basheeraltawil/belt-marking-machine-integrated-with-laser-fiber/analysis/figures/lead_feasibility.png

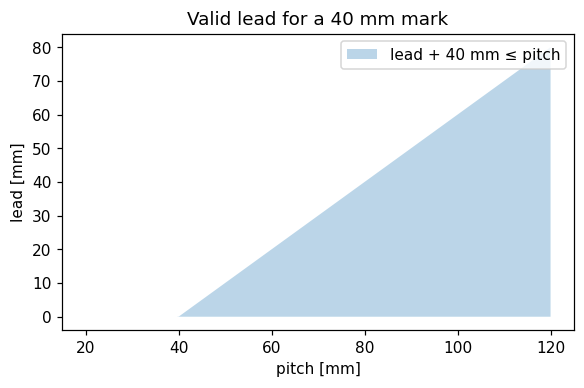
analysis/figures/lead_feasibility.png
