basheeraltawil/belt-marking-machine-integrated-with-laser-fiber/legacy/control_panel_design/Assem1.SLDASM

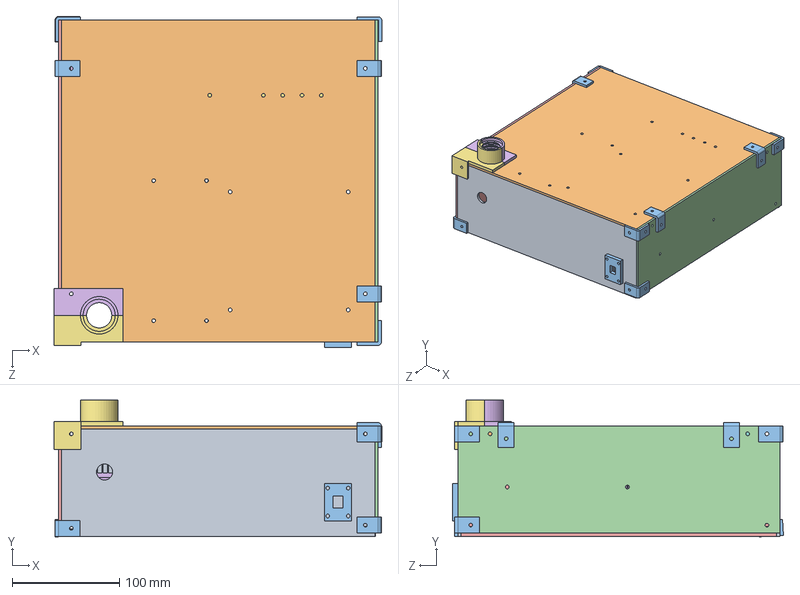
[picture p13: CAD file, 2026-09-28, an earlier design]
legacy/control_panel_design/Assem1.SLDASM
305.4 x 127.5 x 308.4 mm
basen
wall2
holderr x 10
baseupn
baseup
dm542
7 INCH DIN RAIL
driver
left_sidee
KART_HOLDER
usb
relay_support
relaasy
control_cable
control_cable_up
