basheeraltawil/belt-marking-machine-integrated-with-laser-fiber/legacy/control_panel_design/switch.SLDASM

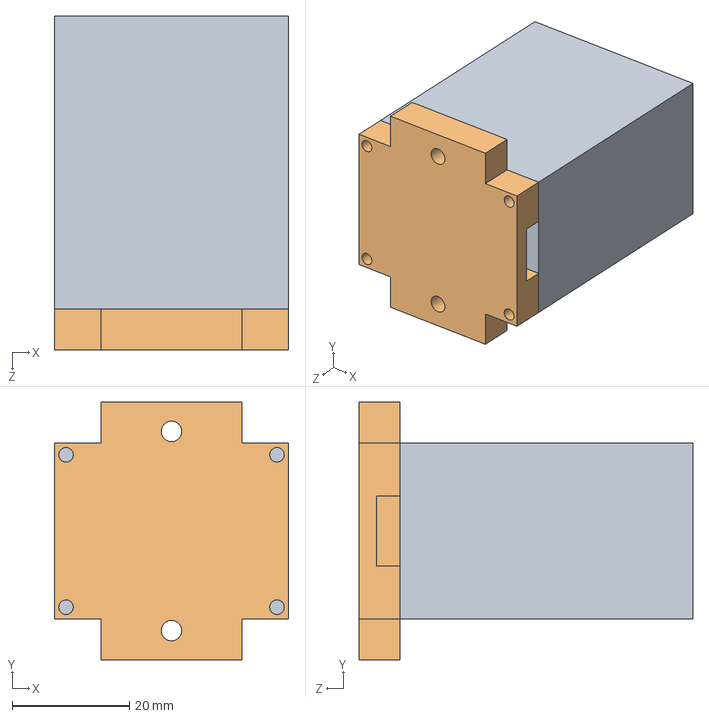
[picture p14: CAD file, 2026-09-28, an earlier design]
legacy/control_panel_design/switch.SLDASM
40.0 x 44.0 x 57.0 mm
switch_body
cover
