basheeraltawil/belt-marking-machine-integrated-with-laser-fiber/legacy/control_panel_design/last_assembly.SLDASM

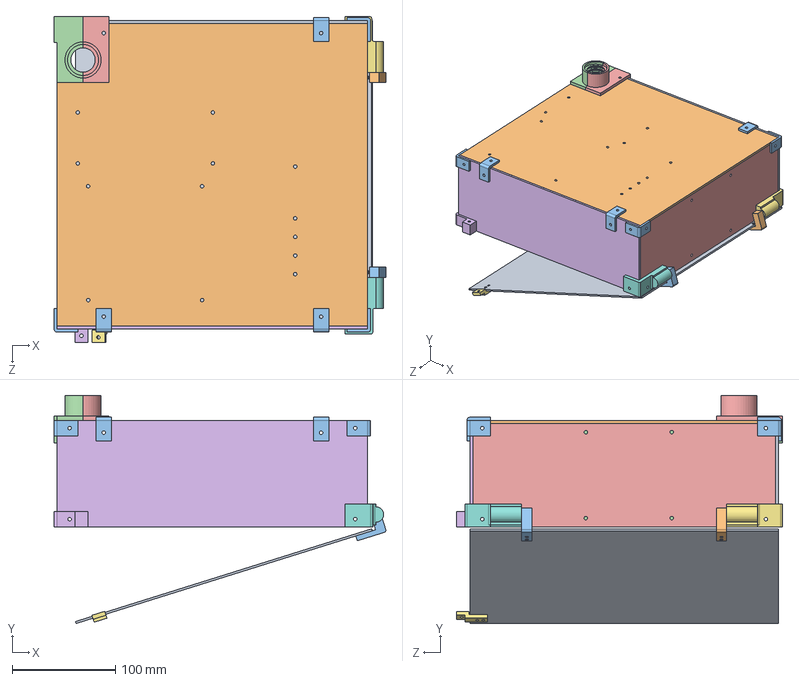
[picture p15: CAD file, 2026-09-28, an earlier design]
legacy/control_panel_design/last_assembly.SLDASM
320.7 x 220.4 x 315.0 mm
baseup
wall2
holderr x 6
basen
left_sidee
upper_d
hinge1
hinge2
kapi
revoluttt1
upper_revolute
control_cable_up
control_cable
totucu
kapi_totucu
