basheeraltawil/belt-marking-machine-integrated-with-laser-fiber/legacy/control_panel_design/sensor_reservior_cover.SLDPRT

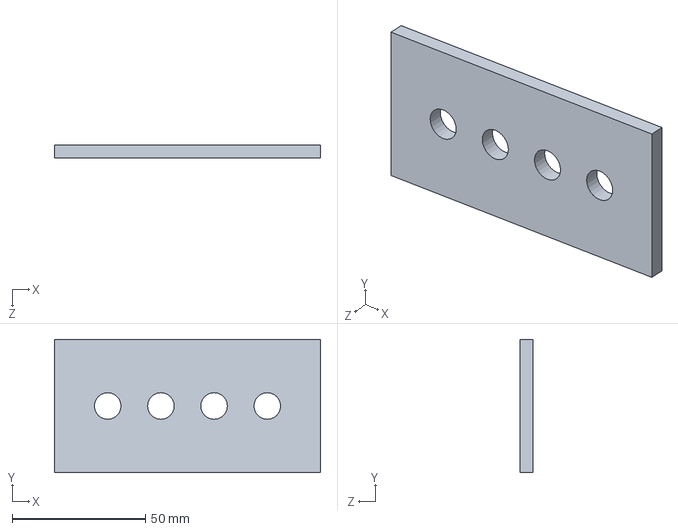
[picture p16: CAD file, 2026-09-28, an earlier design]
legacy/control_panel_design/sensor_reservior_cover.SLDPRT
100.0 x 50.0 x 5.00 mm
