basheeraltawil/belt-marking-machine-integrated-with-laser-fiber/legacy/control_panel_design/step_dosyasi/base.STEP

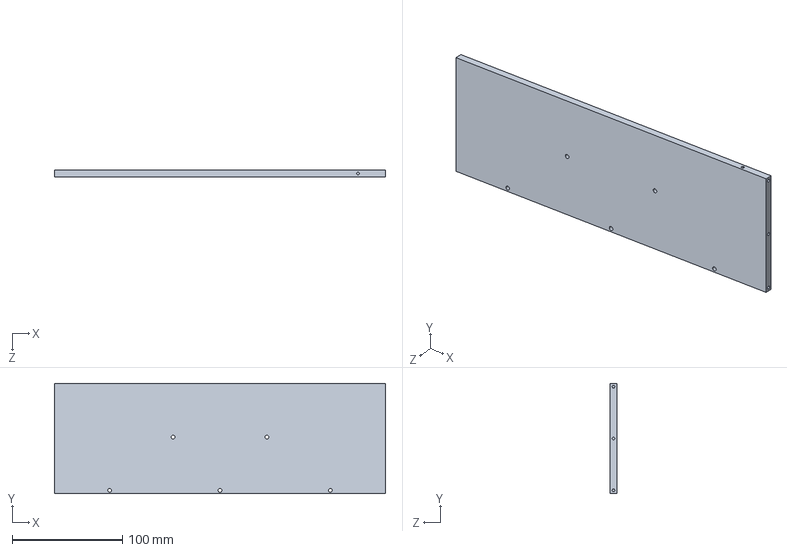
[picture p17: CAD file, 2026-09-28, an earlier design]
legacy/control_panel_design/step_dosyasi/base.STEP
300.0 x 100.0 x 6.00 mm
