basheeraltawil/belt-marking-machine-integrated-with-laser-fiber/legacy/control_panel_design/stepp_file/wall2.STEP

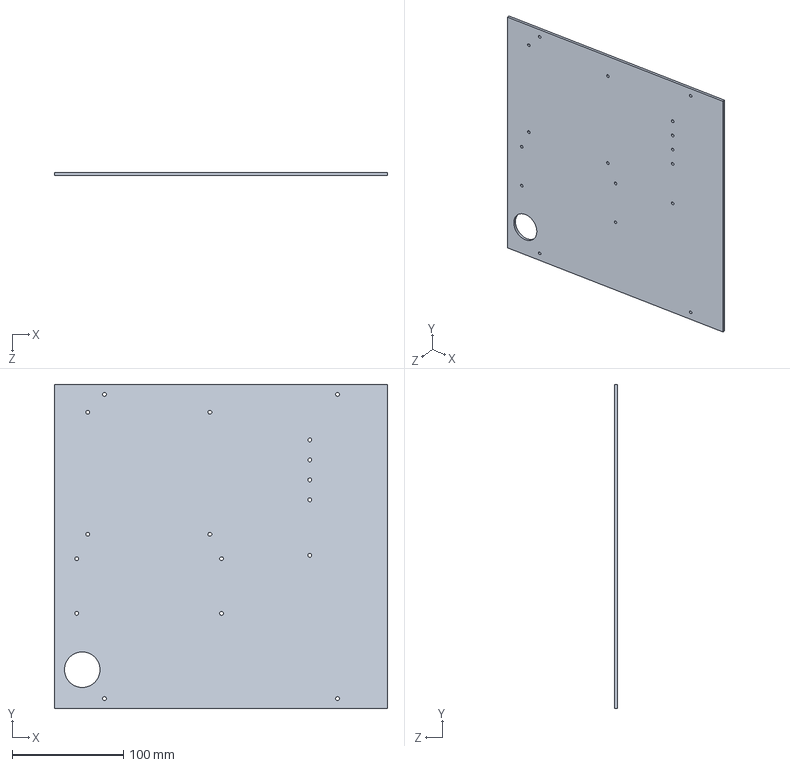
[picture p18: CAD file, 2026-09-28, an earlier design]
legacy/control_panel_design/stepp_file/wall2.STEP
300.0 x 292.0 x 3.00 mm
