basheeraltawil/belt-marking-machine-integrated-with-laser-fiber/legacy/control_panel_design/stepp_file/baseupn.STEP

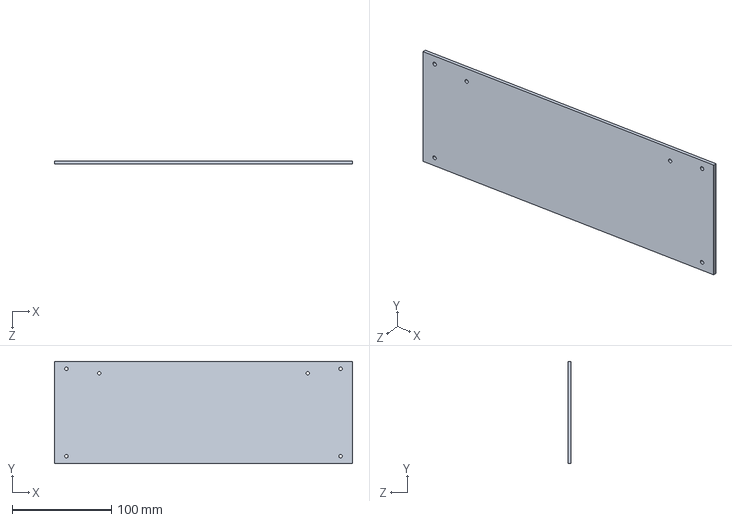
[picture p19: CAD file, 2026-09-28, an earlier design]
legacy/control_panel_design/stepp_file/baseupn.STEP
300.0 x 103.0 x 3.00 mm
