basheeraltawil/belt-marking-machine-integrated-with-laser-fiber/legacy/control_panel_design/switch_body.SLDPRT

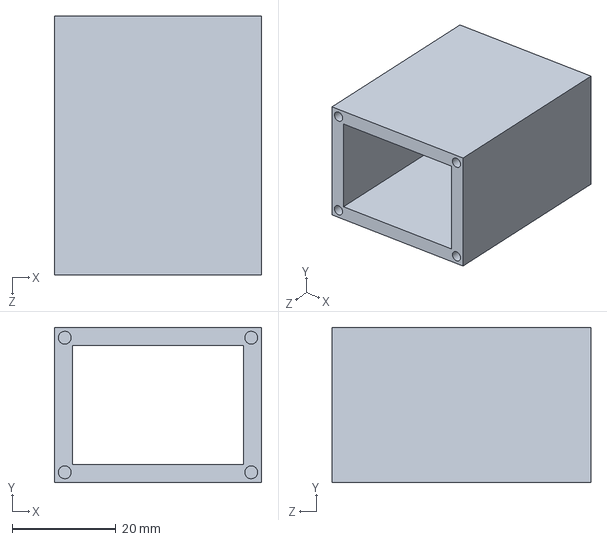
[picture p20: CAD file, 2026-09-28, an earlier design]
legacy/control_panel_design/switch_body.SLDPRT
40.0 x 30.0 x 50.0 mm
