basheeraltawil/belt-marking-machine-integrated-with-laser-fiber/legacy/control_panel_design/B18.3.4M - 3 x 0.5 x 12 SBHCS --C.sldprt

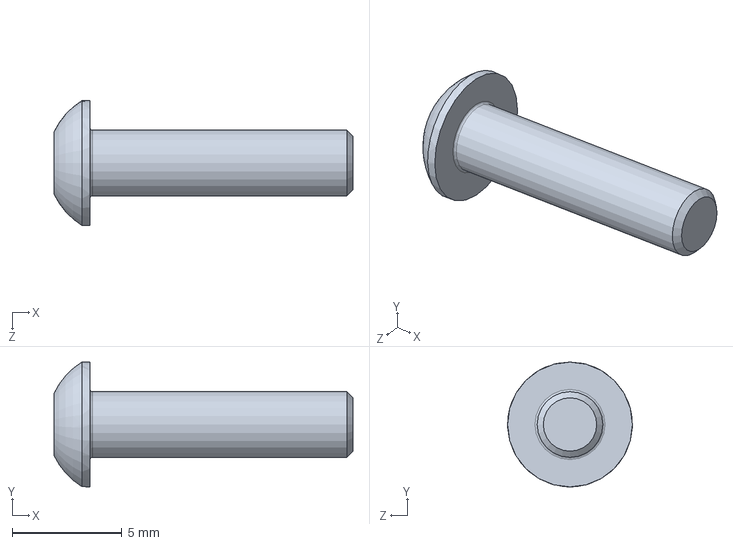
[picture p21: CAD file, 2026-09-28, an earlier design]
legacy/control_panel_design/B18.3.4M - 3 x 0.5 x 12 SBHCS --C.sldprt
13.6 x 5.70 x 5.70 mm
