basheeraltawil/belt-marking-machine-integrated-with-laser-fiber/legacy/control_panel_design/step_dosyasi/holder.STEP

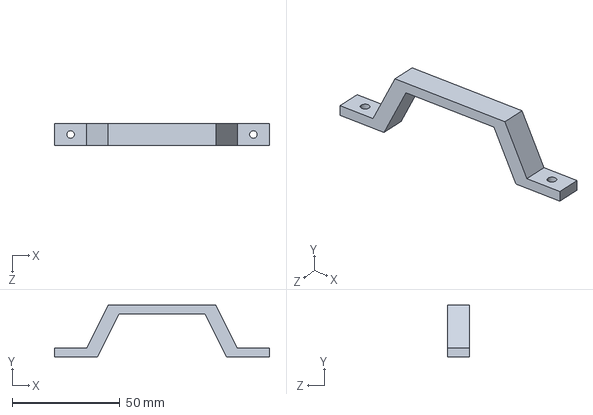
[picture p22: CAD file, 2026-09-28, an earlier design]
legacy/control_panel_design/step_dosyasi/holder.STEP
100.0 x 24.0 x 10.0 mm
