basheeraltawil/belt-marking-machine-integrated-with-laser-fiber/legacy/control_panel_design/stepp_file/holderr.STEP

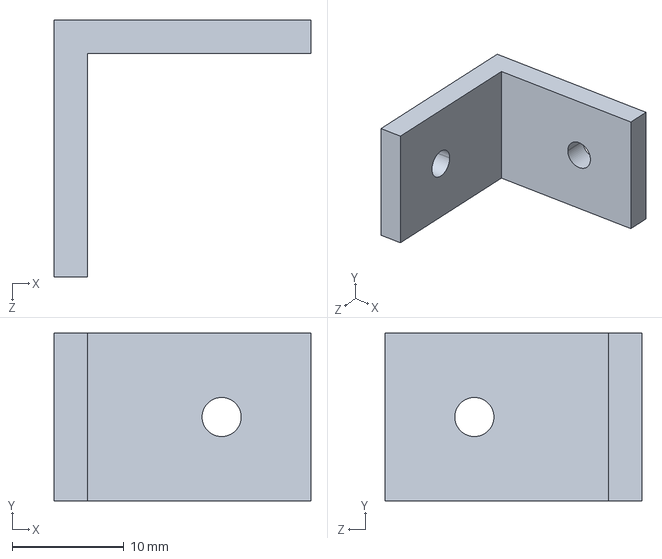
[picture p23: CAD file, 2026-09-28, an earlier design]
legacy/control_panel_design/stepp_file/holderr.STEP
23.0 x 15.0 x 23.0 mm
