basheeraltawil/belt-marking-machine-integrated-with-laser-fiber/legacy/control_panel_design/step_dosyasi/sides.STEP

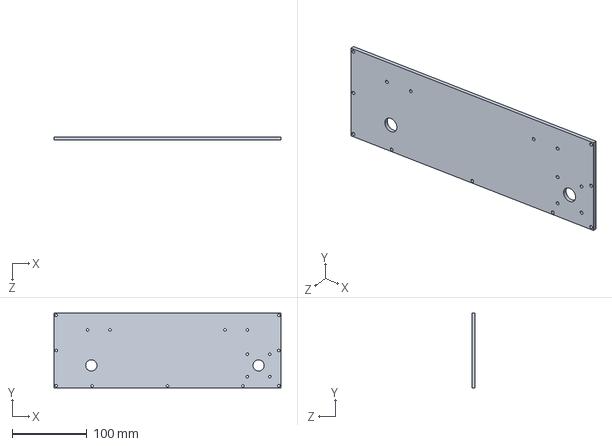
[picture p24: CAD file, 2026-09-28, an earlier design]
legacy/control_panel_design/step_dosyasi/sides.STEP
304.0 x 100.0 x 4.00 mm
