basheeraltawil/belt-marking-machine-integrated-with-laser-fiber/legacy/control_panel_design/stepp_file/left_sidee.STEP

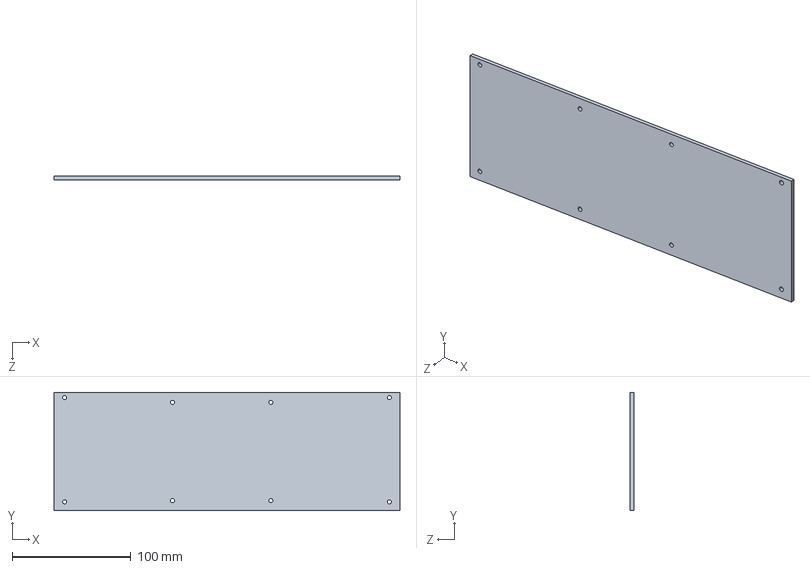
[picture p25: CAD file, 2026-09-28, an earlier design]
legacy/control_panel_design/stepp_file/left_sidee.STEP
292.0 x 100.0 x 3.00 mm
