basheeraltawil/belt-marking-machine-integrated-with-laser-fiber/legacy/control_panel_design/upper_revolute.SLDPRT

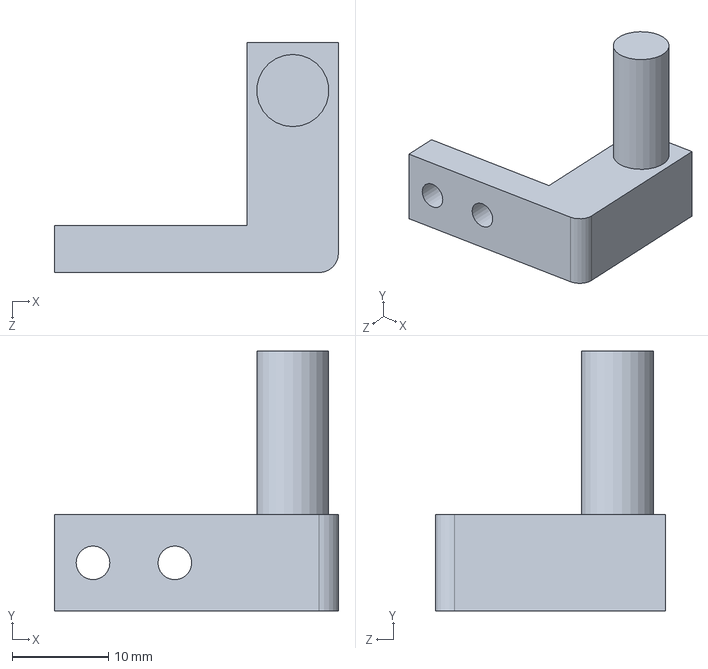
[picture p26: CAD file, 2026-09-28, an earlier design]
legacy/control_panel_design/upper_revolute.SLDPRT
29.5 x 27.0 x 23.9 mm
