basheeraltawil/belt-marking-machine-integrated-with-laser-fiber/legacy/control_panel_design/circulation_pipe_2.SLDPRT

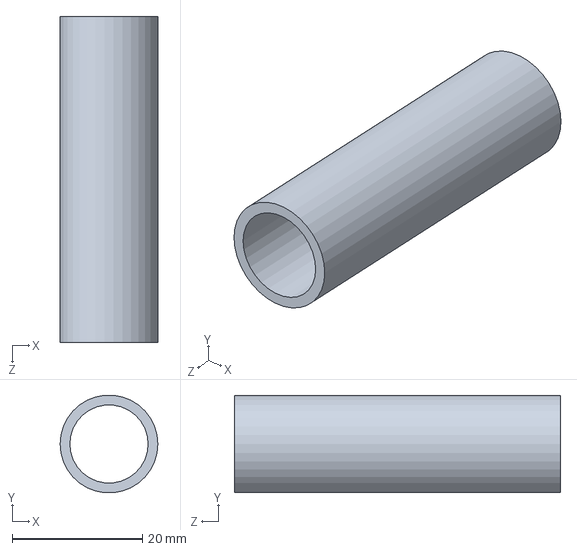
[picture p27: CAD file, 2026-09-28, an earlier design]
legacy/control_panel_design/circulation_pipe_2.SLDPRT
15.0 x 14.9 x 50.0 mm
