basheeraltawil/belt-marking-machine-integrated-with-laser-fiber/legacy/control_panel_design/step_dosyasi/h2.STEP

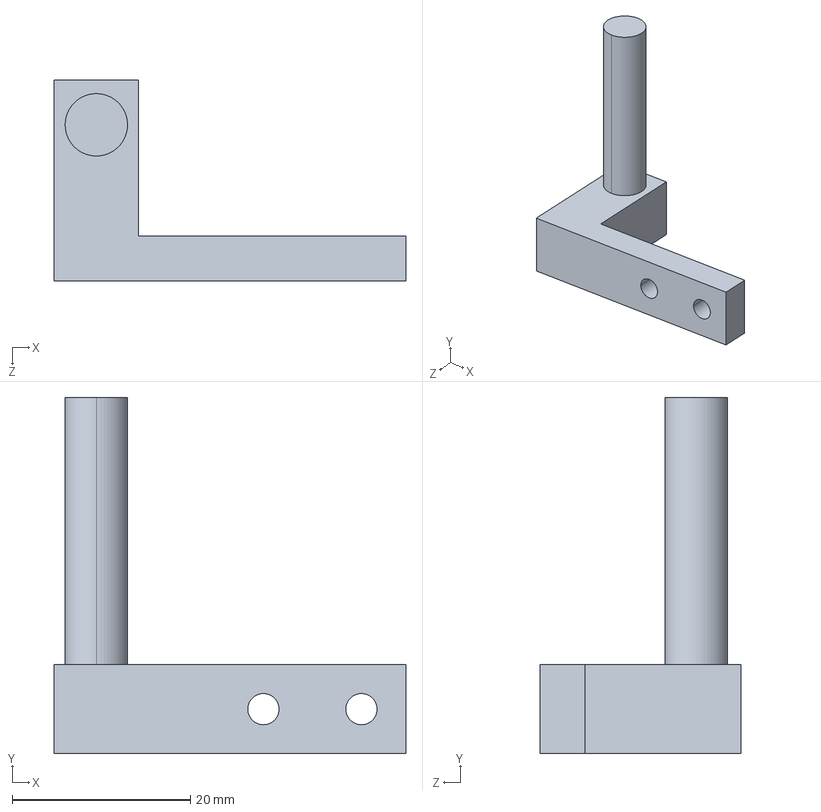
[picture p28: CAD file, 2026-09-28, an earlier design]
legacy/control_panel_design/step_dosyasi/h2.STEP
39.5 x 40.0 x 22.5 mm
