basheeraltawil/belt-marking-machine-integrated-with-laser-fiber/(list of files, cad)

Other CAD files:
legacy/control_panel_design/step_dosyasi/baseup.STEP
legacy/control_panel_design/7 INCH_DIN_RAIL.SLDPRT
legacy/control_panel_design/B18.3.5M - 3 x 0.5 x 25 Socket FCHS -- 25C.sldprt
legacy/control_panel_design/KART_HOLDER.SLDPRT
legacy/control_panel_design/KART_HOLDER.STL
legacy/control_panel_design/base.SLDPRT
legacy/control_panel_design/basen.SLDPRT
legacy/control_panel_design/baseup.SLDPRT
legacy/control_panel_design/baseup1.SLDPRT
legacy/control_panel_design/baseupn.SLDPRT
legacy/control_panel_design/baseupn1.SLDPRT
legacy/control_panel_design/bottle_holder.SLDPRT
legacy/control_panel_design/bottles.SLDPRT
legacy/control_panel_design/bottles_holder.SLDPRT
legacy/control_panel_design/circulation_pipe.SLDPRT
legacy/control_panel_design/control_cable.SLDPRT
legacy/control_panel_design/control_cable_up.SLDPRT
legacy/control_panel_design/cover.SLDPRT
legacy/control_panel_design/cover.STL
legacy/control_panel_design/dm542.SLDPRT
legacy/control_panel_design/driver.SLDPRT
legacy/control_panel_design/footprint.SLDPRT
legacy/control_panel_design/footprint1.SLDPRT
legacy/control_panel_design/frontdoor.SLDPRT
legacy/control_panel_design/h1.SLDPRT
legacy/control_panel_design/h2.SLDPRT
legacy/control_panel_design/hinge.SLDPRT
legacy/control_panel_design/hinge1.SLDPRT
legacy/control_panel_design/hinge1.STL
legacy/control_panel_design/hinge2.SLDPRT
legacy/control_panel_design/hinge2.STL
legacy/control_panel_design/hingeee1.STL
legacy/control_panel_design/hinggg1.STL
legacy/control_panel_design/holder.SLDPRT
legacy/control_panel_design/holderr.SLDPRT
legacy/control_panel_design/holderr.STL
legacy/control_panel_design/holderr1.SLDPRT
legacy/control_panel_design/kapi.SLDPRT
legacy/control_panel_design/kapi.STEP
legacy/control_panel_design/kapi_totucu.SLDPRT
legacy/control_panel_design/kart.SLDPRT
legacy/control_panel_design/key.SLDPRT
legacy/control_panel_design/left_sidee.SLDPRT
legacy/control_panel_design/pump.SLDPRT
legacy/control_panel_design/pumps_holder.SLDPRT
legacy/control_panel_design/pumps_holder2.SLDPRT
legacy/control_panel_design/relaasy.SLDPRT
legacy/control_panel_design/relay.SLDPRT
legacy/control_panel_design/relay_support.SLDPRT
legacy/control_panel_design/relay_support.STL
legacy/control_panel_design/revolute.SLDPRT
legacy/control_panel_design/revolute.STL
legacy/control_panel_design/revoluttt1.SLDPRT
legacy/control_panel_design/revoluttt1.STL
legacy/control_panel_design/revoluuut.STL
legacy/control_panel_design/right_side.SLDPRT
legacy/control_panel_design/rubber pipe.SLDPRT
legacy/control_panel_design/sensor_r_holder.SLDPRT
legacy/control_panel_design/sensor_r_holder1.SLDPRT
legacy/control_panel_design/sensor_reservoir.SLDPRT
legacy/control_panel_design/sides.SLDPRT
legacy/control_panel_design/step_dosyasi/footprint1.STEP
legacy/control_panel_design/step_dosyasi/frontdoor.STEP
legacy/control_panel_design/step_dosyasi/right_side.STEP
legacy/control_panel_design/step_dosyasi/wall2.STEP
legacy/control_panel_design/stepp_file/basen.STEP
legacy/control_panel_design/stepp_file/baseup.STEP
legacy/control_panel_design/switch_body.STL
legacy/control_panel_design/totucu.SLDPRT
legacy/control_panel_design/upper_d.SLDPRT
legacy/control_panel_design/upper_revolute.STL
legacy/control_panel_design/usb.SLDPRT
legacy/control_panel_design/usb.STL
legacy/control_panel_design/wall.SLDPRT
legacy/control_panel_design/wall2.SLDPRT
