basheeraltawil/belt-marking-machine-integrated-with-laser-fiber/docs/images/ui_calibration.png

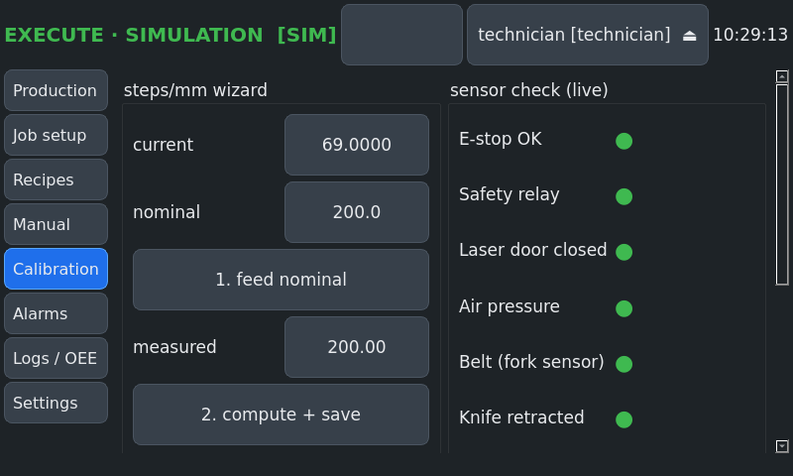
docs/images/ui_calibration.png
