basheeraltawil/belt-marking-machine-integrated-with-laser-fiber/ros2_ws/src/belt_marking_bringup/config/multi_laser.yaml

# Overlay for a two-station line: loaded on top of machine.yaml by
# multi_laser_sim.launch.py (only the keys below change).
machine:
  knife_offset_mm: 230.0           # knife after the second laser machine
laser:
  num_stations: 2
  station_offsets_mm: [0.0, 150.0]
  station_delays_s: [0.0, 0.3]
  station_enabled: [true, true]
