basheeraltawil/belt-marking-machine-integrated-with-laser-fiber/(commit log)

2026-09-28 Milestone 1: preserve legacy material, legacy analysis, architecture and assumptions
    - Move original CAD, video and README into legacy/ (identical duplicate under
    laser_machine_code/ dropped)
    - Restore the deleted Arduino firmware (2 variants), Processing UI and project
    PDF from git history into legacy/
    - docs/LEGACY_ANALYSIS.md, docs/ARCHITECTURE.md, docs/ASSUMPTIONS.md
    - Add MIT LICENSE and .gitignore
    [7 INCH_DIN_RAIL.SLDPRT, Assem1.SLDASM, B18.3.4M - 3 x 0.5 x 12 SBHCS --C.sldprt, B18.3.5M - 3 x 0.5 x 25 Socket FCHS -- 25C.sldprt, KART_HOLDER.SLDPRT, KART_HOLDER.STL, assemblyy.SLDASM, base.SLDPRT]
2026-09-28 Milestone 2: ROS 2 interfaces, parametric URDF/xacro and RViz view
    - belt_marking_interfaces: MachineState, Alarm, IoStatus, JobSpec, LaserStation,
    ProcessEvent, QualityResult, RunJob action, manual/recipe/state/hardware services
    - belt_marking_description: xacro model (conveyor, rollers, fork sensor, N CO2 laser
    stations with head gantry and beam, traversing knife with reed sensors, camera,
    E-stop, light tower, bin), Gazebo extras, joint_state_node, RViz config, tests
    [belt_marking_machine.urdf.xacro, gazebo.xacro, macros.xacro]
2026-09-28 Milestone 3: control state machine, job planner, plant model and tests
    - belt_marking_laser: LaserInterface, DryContactLaser (pedal relay, signal/timed done),
    SimCo2Laser device model with fault injection
    - belt_marking_hardware: HardwareInterface/IoSnapshot, FakePlant (stepper, knife,
    lasers, belt supply, firmware interlocks + watchdog, faults), PlantHal, RosHardwareClient,
    sim_hardware_node (hw/command, hw/io_status, sim/inject_fault, sim/plant_events)
    - belt_marking_control: PackML state machine + job sequencer, forward-only belt-coordinate
    planner, alarm catalogue/manager, SQLite DB (recipes, jobs, log, alarms, users, audit,
    cycle times), OEE, control_node (RunJob action + serv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
2026-09-28 Milestone 4: Gazebo Fortress digital twin, bringup and single-file machine config
    - belt_marking_gazebo: world (physics, sensors, overview camera), ros_gz bridges
    (joint commands, QA camera, create/remove/set_pose services), gz_twin_node: laser
    mark decals travel with the belt, cut pieces (with their marks) spawned as dynamic
    bodies and ejected down the chute into the bin, knife/laser head/beam joints animated
    - belt_marking_bringup: config/machine.yaml (single source, TODO markers), multi-laser
    overlay, config_loader + stack builder, sim/real/multi_laser_sim launch files
    - URDF fixes (unique beam link name, belt strip to conveyor end, centred QA camera)
    - docs/images/gazebo_overview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
    [belt_marking.sdf, belt_marking_machine.urdf.xacro, gazebo.xacro, machine.yaml, macros.xacro]
2026-09-28 Milestone 5: touchscreen operator UI (PyQt5 + rclpy)
    - 8 screens: production, job setup (validated with the controller's rules, confirm
    before start), recipes, manual (press-and-hold jog), calibration (steps/mm wizard,
    knife/laser tests, live sensor check), alarms (remedy text, history), logs/OEE (CSV
    export to USB), settings (language en/tr, users + PIN roles, audit trail, simulation
    fault injection)
    - fits 800x480 (tested), on-screen keypad, auto logout, FakeBridge demo mode
    - control: startup grace period before the link-lost alarm; joint_state_node uses
    sensor-data QoS for hw/io_status
    - screenshots from the UI running against the live simulation
    [machine.yaml]
2026-09-28 Milestone 6: Arduino Mega firmware, framed serial protocol, serial bridge node
    - firmware/arduino_mega (PlatformIO): non-blocking loop, AccelStepper, debounced inputs,
    pulse timers, heartbeat watchdog (armed by first heartbeat) + AVR WDT, interlocks,
    pins.h/config.h (legacy pins kept); portable protocol/logic libs with 12 native unit
    tests; builds for the Mega (RAM 7.7 %, flash 5.4 %)
    - protocol.py (CRC16-CCITT, resyncing parser), FirmwareClient (ACK/NAK, retries,
    de-duplication), VirtualFirmware (plant model behind the real protocol)
    - serial_bridge_node: lifecycle node, auto-reconnect, heartbeat forwarding only while
    control_node is alive, tolerant of spurious serial readiness
    -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
2026-09-28 Milestone 7: automated scenarios, ROS launch test, CI and Docker
    - launch_testing integration test: real node graph headless, RunJob action,
    belt run-out fault -> HELD -> resume with counts kept
    - docs/SCENARIOS.md: 12 scenarios with setup, expected behaviour, acceptance
    criteria, fault injection reference, reuse as SAT
    - GitHub Actions: colcon build/test in ros:humble (unit, scenarios incl. soak,
    launch test, offscreen UI, flake8), PlatformIO native tests + Mega build, ruff +
    clang-format
    - docker/: simulation image (Humble + Gazebo Fortress), compose services sim (X11),
    headless and test; verified: 90 tests pass inside the image
    - firmware formatted with clang-format (Google styl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
2026-09-28 Milestone 8: Raspberry Pi deployment, implementation guide and manuals
    - raspberry_pi/: idempotent setup_pi.sh (Humble, workspace build, service user),
    udev rule /dev/belt_arduino, systemd services (ROS stack + cage kiosk UI),
    logrotate, journald limit, backup/restore, optional overlayroot; Pi 5 notes
    - docs: ELECTRICAL (power, hardwired safety chain, dry-contact pedal wiring, laser busy
    input, pin map, DM542), PNEUMATICS (circuit, dump valve, knife timing), MECHANICAL
    (layout, cabinet reuse, BOM + upgrades with rough cost), IMPLEMENTATION_GUIDE
    (11 commissioning steps with checklists, SAT), OPERATOR_MANUAL (alarm table generated
    from the catalogue), MAINTENANCE (schedule, spares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
2026-09-28 Milestone 9: AI features (vision QA, drift detection, assistant, NL job entry)
    - belt_marking_vision: MarkInspector (presence, contrast, position, optional OCR),
    vision_qa_node (camera mode picks the frame where each mark passes the camera;
    synthetic mode renders labels from plant ground truth) -> quality/result
    - anomaly: robust median/MAD drift detector + multivariate detector naming the signal;
    anomaly_node reads cycle_times -> maintenance/drift -> W-702 (Isolation Forest
    evaluated and rejected, documented)
    - offline read-only docs assistant (BM25 + exact alarm answers, optional local LLM)
    - natural-language job entry (UI 'Describe job...' fills the form, operator confirms)
    - cont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
2026-09-28 Vision QA: belt ROI, contrast threshold from measurements, logger crash fix
    - inspector: roi_across (belt band), min_contrast 115 (between good 150 and weak 87 in
    Gazebo, good 150 / weak 51 synthetic)
    - vision_qa_node: log every verdict; fix rclpy 'severity cannot be changed' crash
    - verified with the Gazebo QA camera: good marks OK, weak marks rejected -> W-601
2026-09-28 Milestone 10: README, final assumptions list
    - root README: summary, history, features, architecture, layout, Docker quick start,
    native install, scenarios/tests, BOM + upgrades, wiring and safety summary,
    deployment, AI features, roadmap, CO2-vs-fiber naming note, license and credits
    - ASSUMPTIONS: fork offset, laser field, step-rate limit, watchdog arming, startup
    grace, vision calibration, drift defaults, first-label alignment
2026-09-28 Package docs for the assistant in Docker and on the Pi
    - Dockerfile copies docs/ so the belt_marking_vision docs symlink resolves
    - setup_pi.sh copies symlinked content (rsync -L)
    - verified: 114/114 tests pass inside the rebuilt image
2026-10-01 Add engineering analysis: calibration, motion, cycle time, layout, pneumatics, OEE, drift
    Runnable scripts with equations and figures; reuse the planner, plant model and drift
    detector. Cycle-time model agrees with the simulation within 1.4-2.9 %.
2026-10-01 Rename repository to ros2-laser-marking-machine
    Update clone URLs and drop the note about the old repository name.
